democloid/picoTracker-pcb/README.md

# PCB for PicoTrackerPortable
All data in order to fabricate the PCB for the portable version of [picoTracker](https://github.com/democloid/picoTracker)

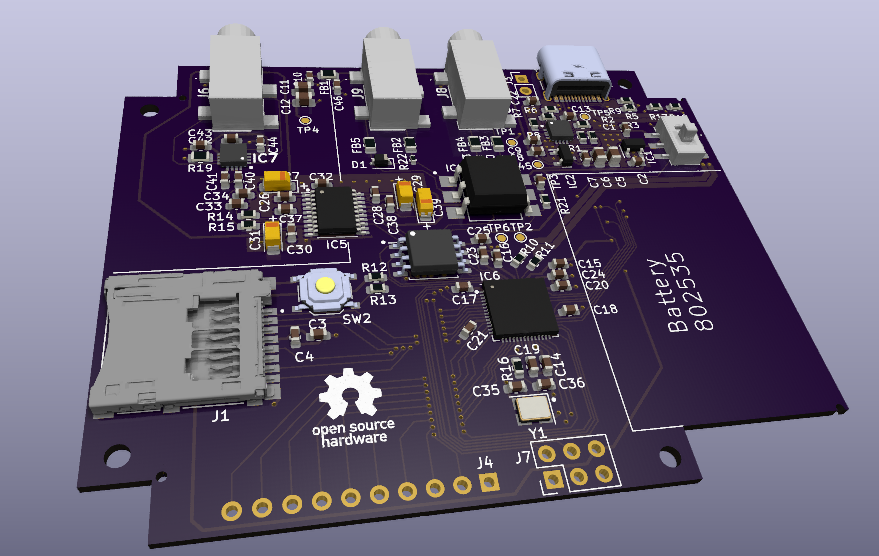
[picture p1: img/pcb.png]
picoTrakerPCB
