democloid/picoTracker-pcb/ref/2012062037_G-Switch-MS-22D28-G020_C963205.pdf

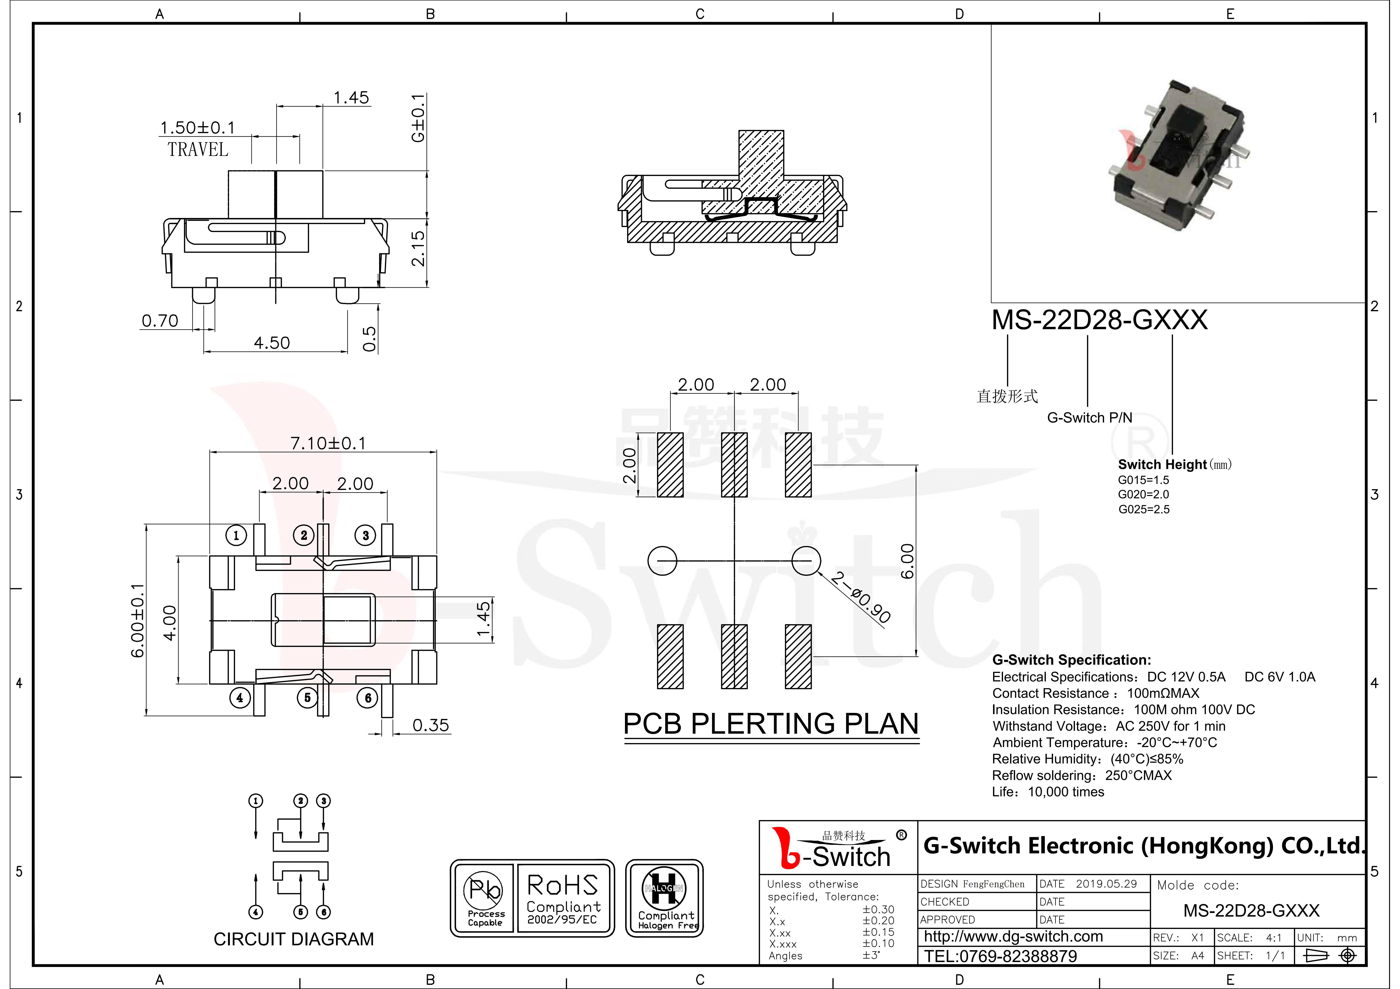
[picture p2: page 1]
