democloid/picoTracker-pcb/ref/2303271630_G-Switch-GT-USB-7010ASV_C2988369.pdf

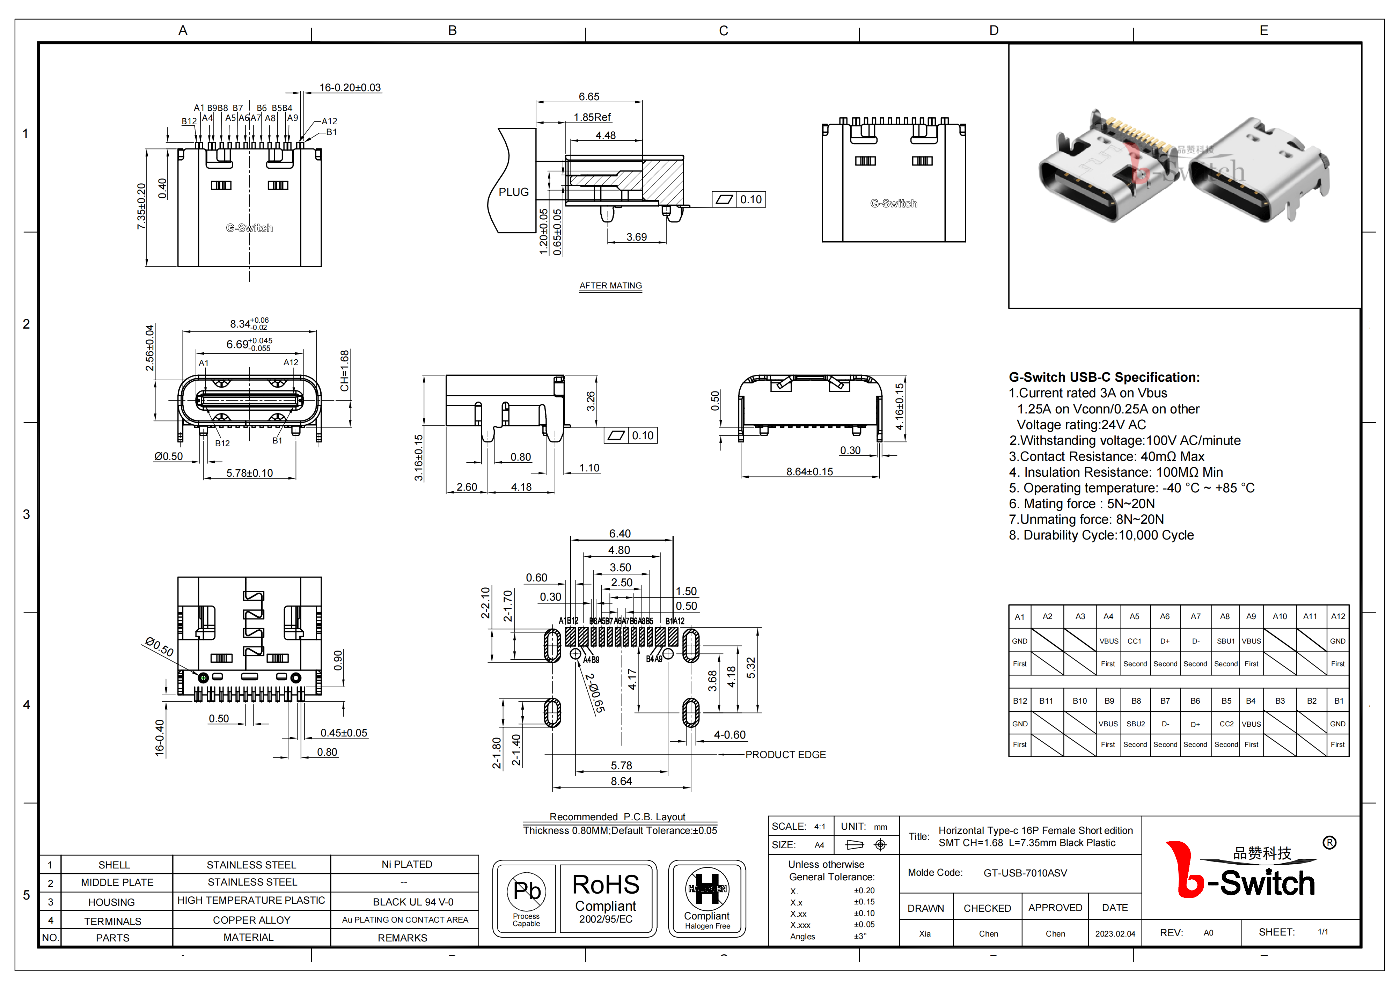
[picture p3: page 1]
