democloid/picoTracker-pcb/ref/2.8-display/H6192d027e66647838c1804a724006072S.webp

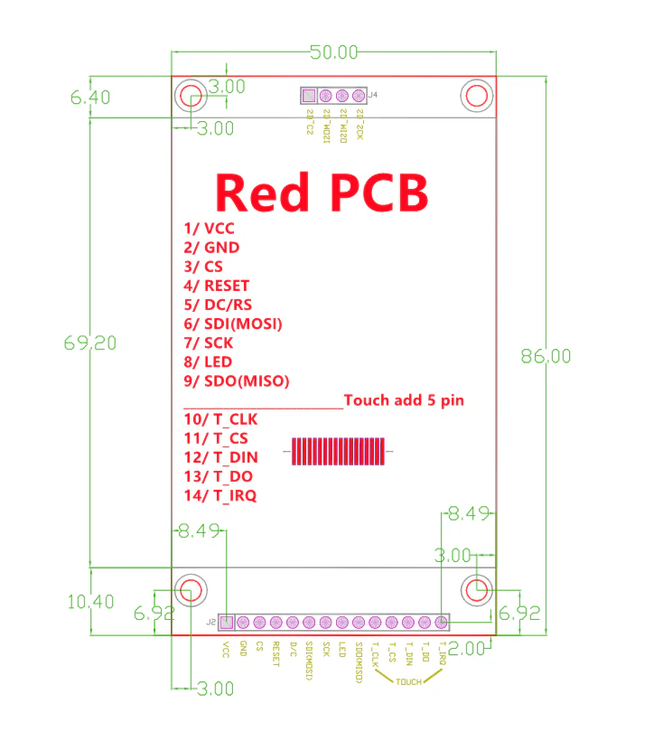
ref/2.8-display/H6192d027e66647838c1804a724006072S.webp
