democloid/picoTracker-pcb/ref/2.8-display/Hd9df9ed48139469ca7c890e34af72170M.webp

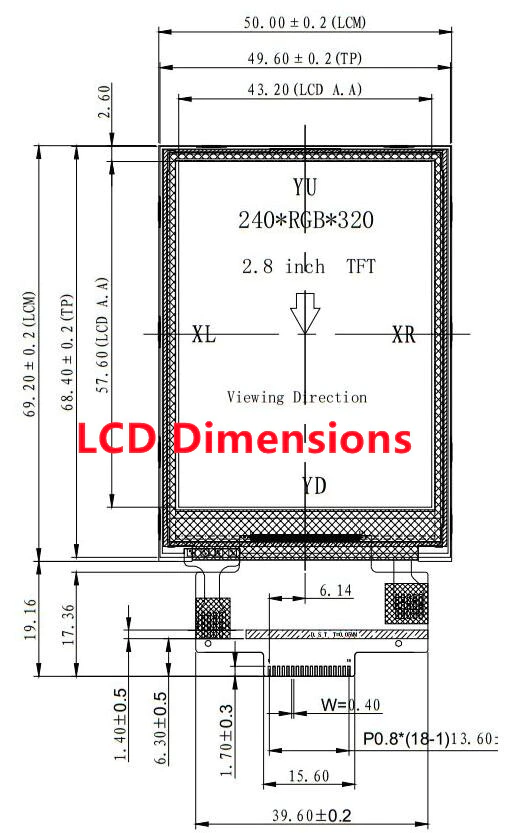
ref/2.8-display/Hd9df9ed48139469ca7c890e34af72170M.webp
