democloid/picoTracker-pcb/ref/2.8-display/He4b2adbe0c284c2fb6346b52f02b134el.webp

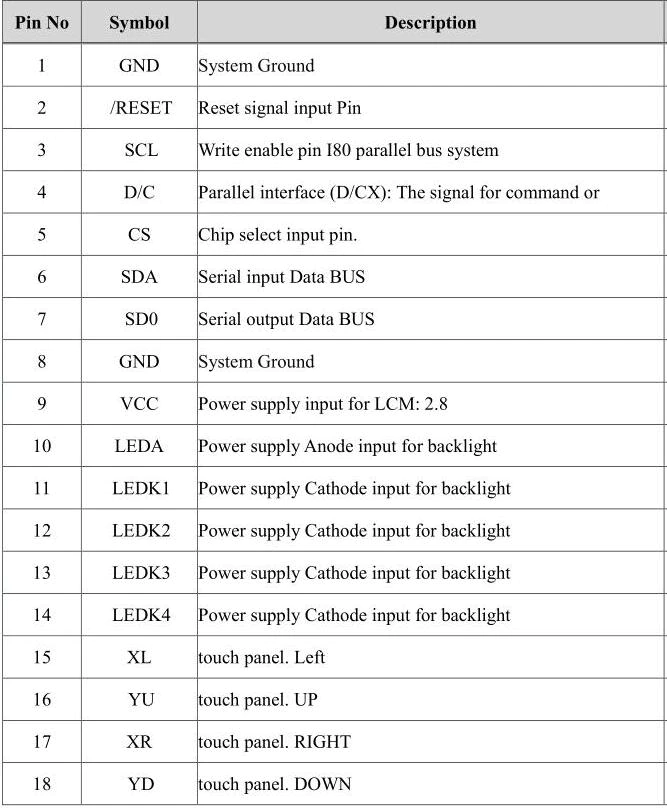
ref/2.8-display/He4b2adbe0c284c2fb6346b52f02b134el.webp
