democloid/picoTracker-pcb/ref/2.8-display/S9d542727d983450b87a73b10d5537359R.webp

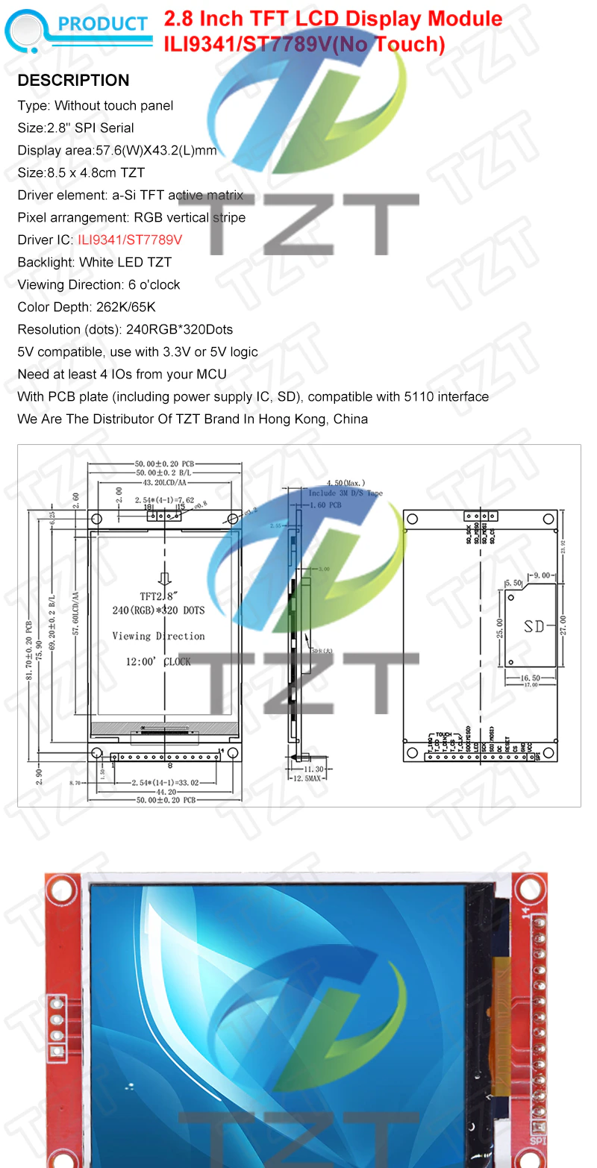
ref/2.8-display/S9d542727d983450b87a73b10d5537359R.webp
