democloid/picoTracker-pcb/ref/2.8-display/S6626c89bae8d4c0187cf21cafde3b4b0q.webp

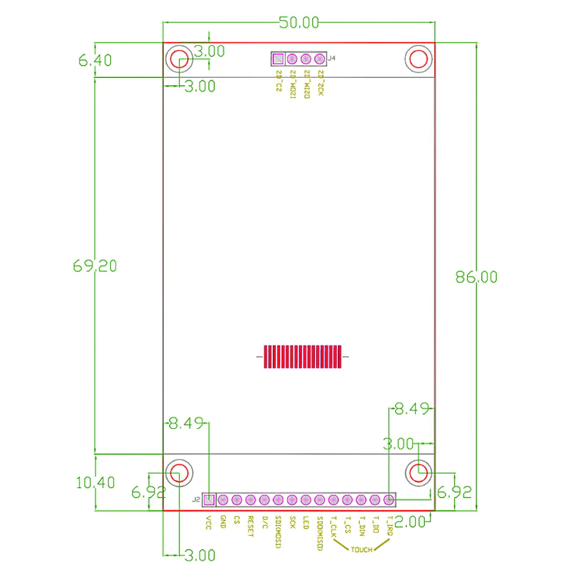
ref/2.8-display/S6626c89bae8d4c0187cf21cafde3b4b0q.webp
