democloid/picoTracker-pcb/ref/2.8-display/S024816b3a2554a78b2b5b220d4f1daffU.webp

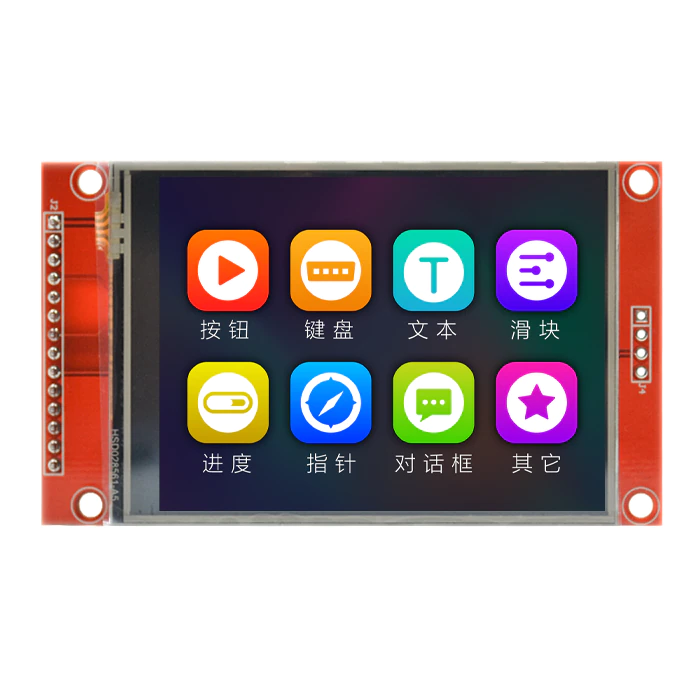
ref/2.8-display/S024816b3a2554a78b2b5b220d4f1daffU.webp
