democloid/picoTracker-pcb/ref/2.8-display/S857096e1b7784f3091919ac16b6c53cbk.webp

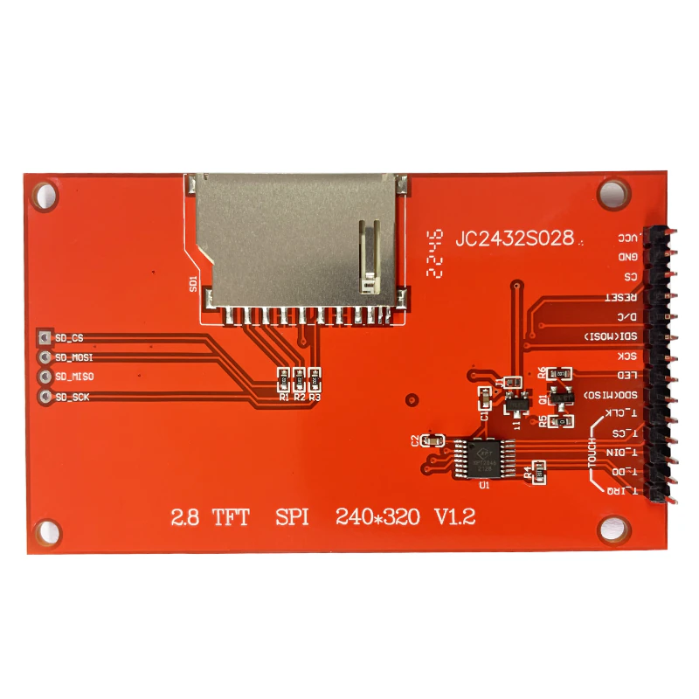
ref/2.8-display/S857096e1b7784f3091919ac16b6c53cbk.webp
