democloid/picoTracker-pcb/ref/2.8-display/Sc483274bce764f2aa723527542338a0eR.webp

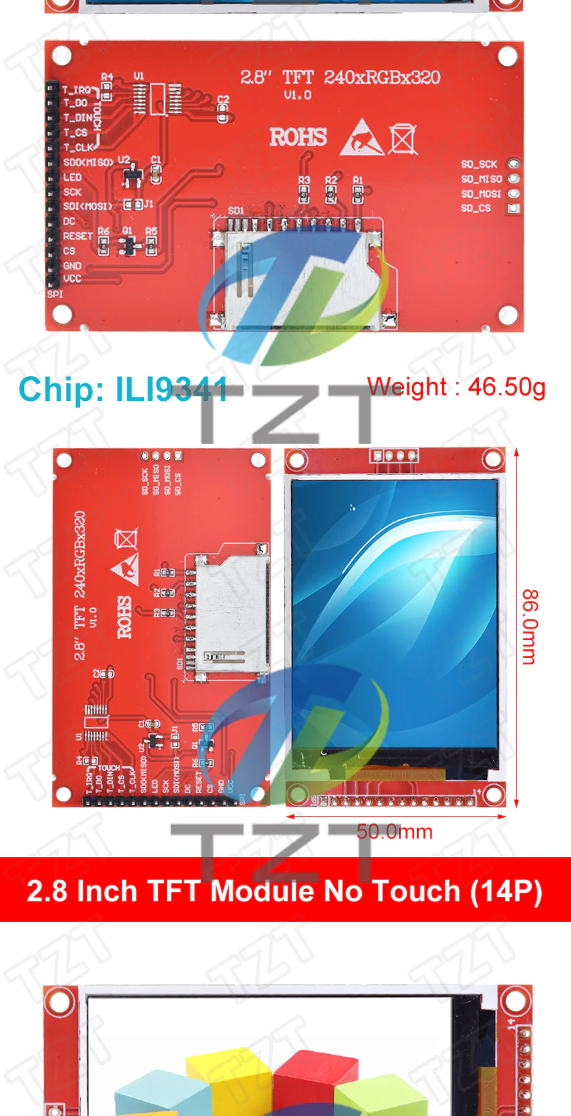
ref/2.8-display/Sc483274bce764f2aa723527542338a0eR.webp
