democloid/picoTracker-pcb/ref/71qR8LfjoXL._AC_SL1500_.jpg

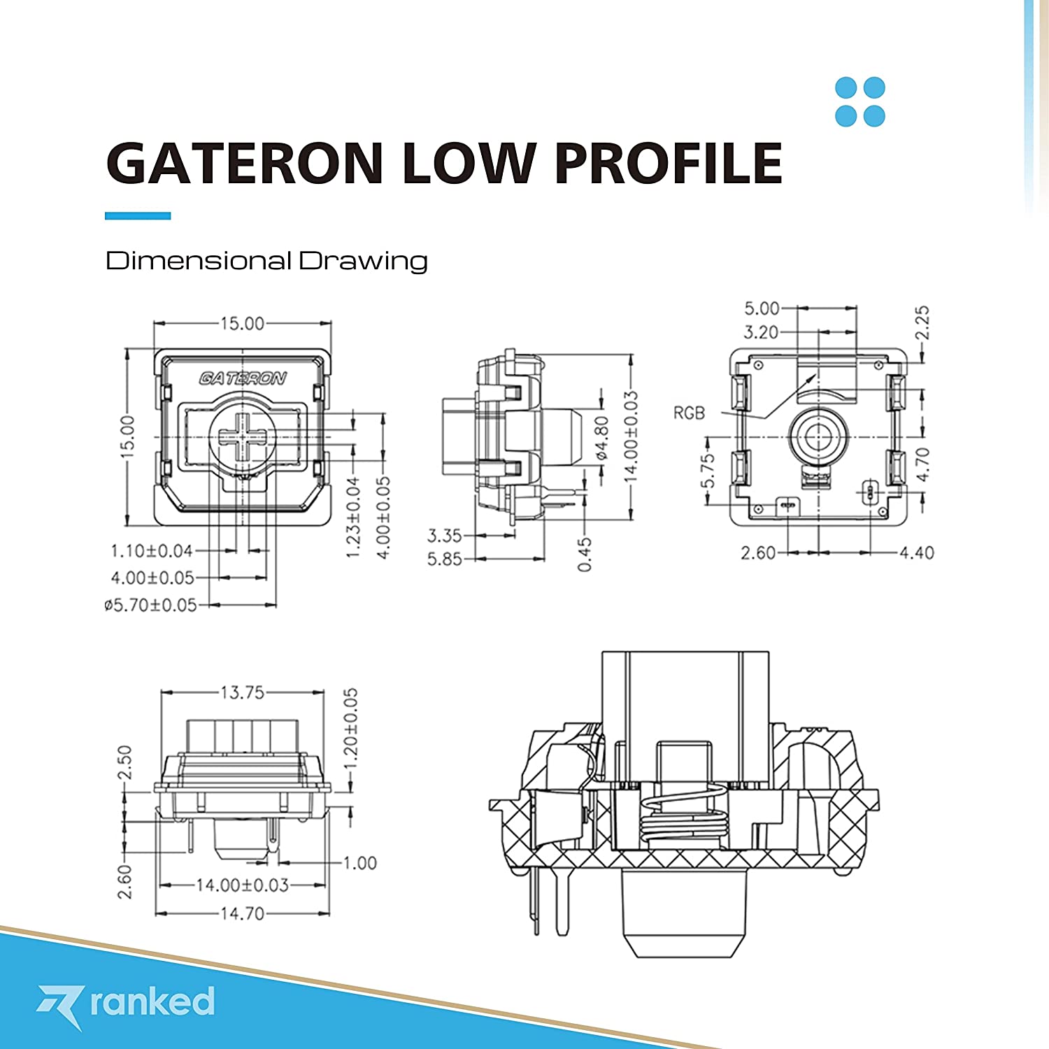
ref/71qR8LfjoXL._AC_SL1500_.jpg
