democloid/picoTracker-pcb/ref/1810121720_Korean-Hroparts-Elec-PJ-327C-4A_C145813.pdf

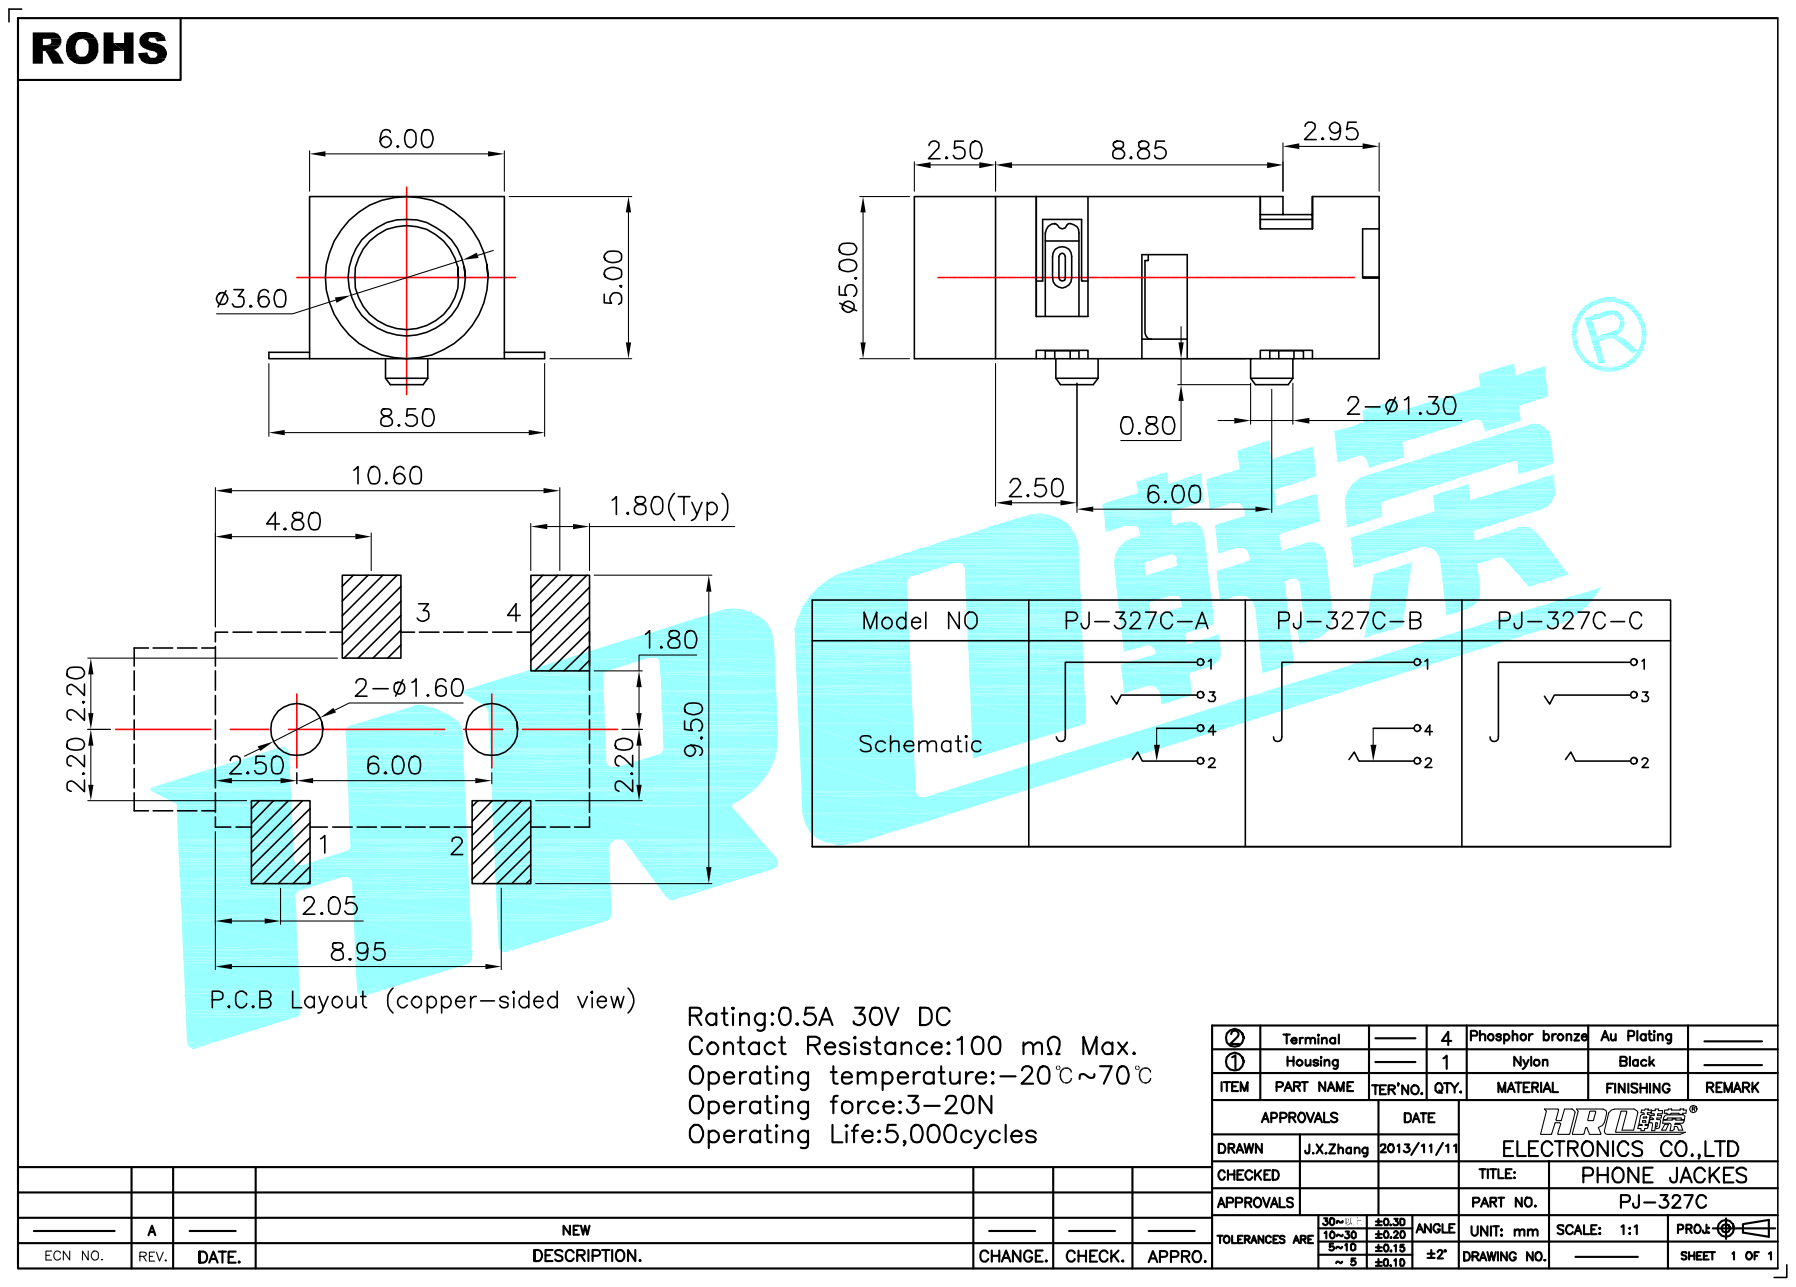
[picture p13: page 1]
