democloid/picoTracker-pcb/keys/picoTracker.kicad_pcb

## KiCad design keys/picoTracker.kicad_pcb (2023-06-05)

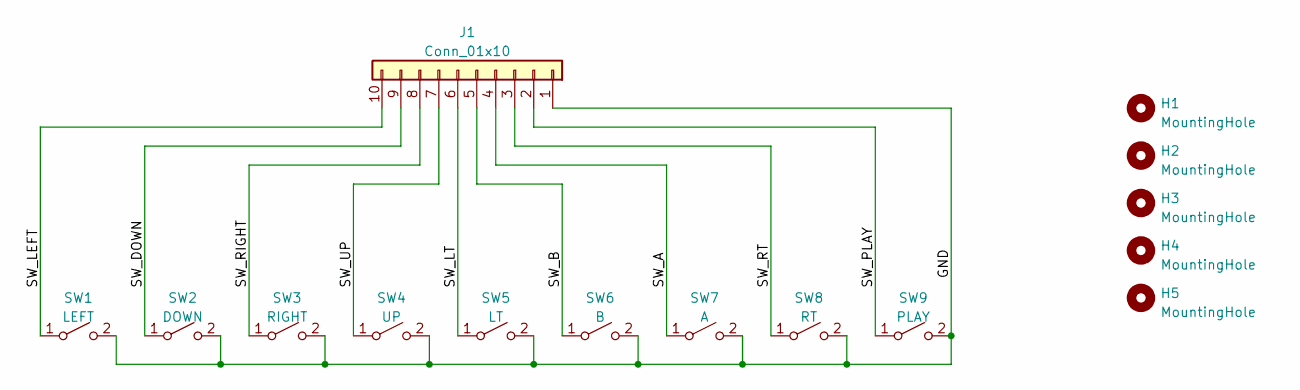
[picture p18: schematic picoTracker.kicad_sch, picoTrackerPortable keys]

Parts:
H1, H2, H3, H4, H5: MountingHole; MountingHole_2.2mm_M2
J1: Conn_01x10; PinHeader_1x10_P2.54mm_Vertical
SW1: LEFT; Cherry-MX-Low-Profile
SW2: DOWN; Cherry-MX-Low-Profile
SW3: RIGHT; Cherry-MX-Low-Profile
SW4: UP; Cherry-MX-Low-Profile
SW5: LT; Cherry-MX-Low-Profile
SW6: B; Cherry-MX-Low-Profile
SW7: A; Cherry-MX-Low-Profile
SW8: RT; Cherry-MX-Low-Profile
SW9: PLAY; Cherry-MX-Low-Profile

Connections:
/GND: J1.1, SW1.2 (B), SW2.2 (B), SW3.2 (B), SW4.2 (B), SW5.2 (B), SW6.2 (B), SW7.2 (B), SW8.2 (B), SW9.2 (B)
/SW_A: J1.4, SW7.1 (A)
/SW_B: J1.5, SW6.1 (A)
/SW_DOWN: J1.9, SW2.1 (A)
/SW_LEFT: J1.10, SW1.1 (A)
/SW_LT: J1.6, SW5.1 (A)
/SW_PLAY: J1.2, SW9.1 (A)
/SW_RIGHT: J1.8, SW3.1 (A)
/SW_RT: J1.3, SW8.1 (A)
/SW_UP: J1.7, SW4.1 (A)

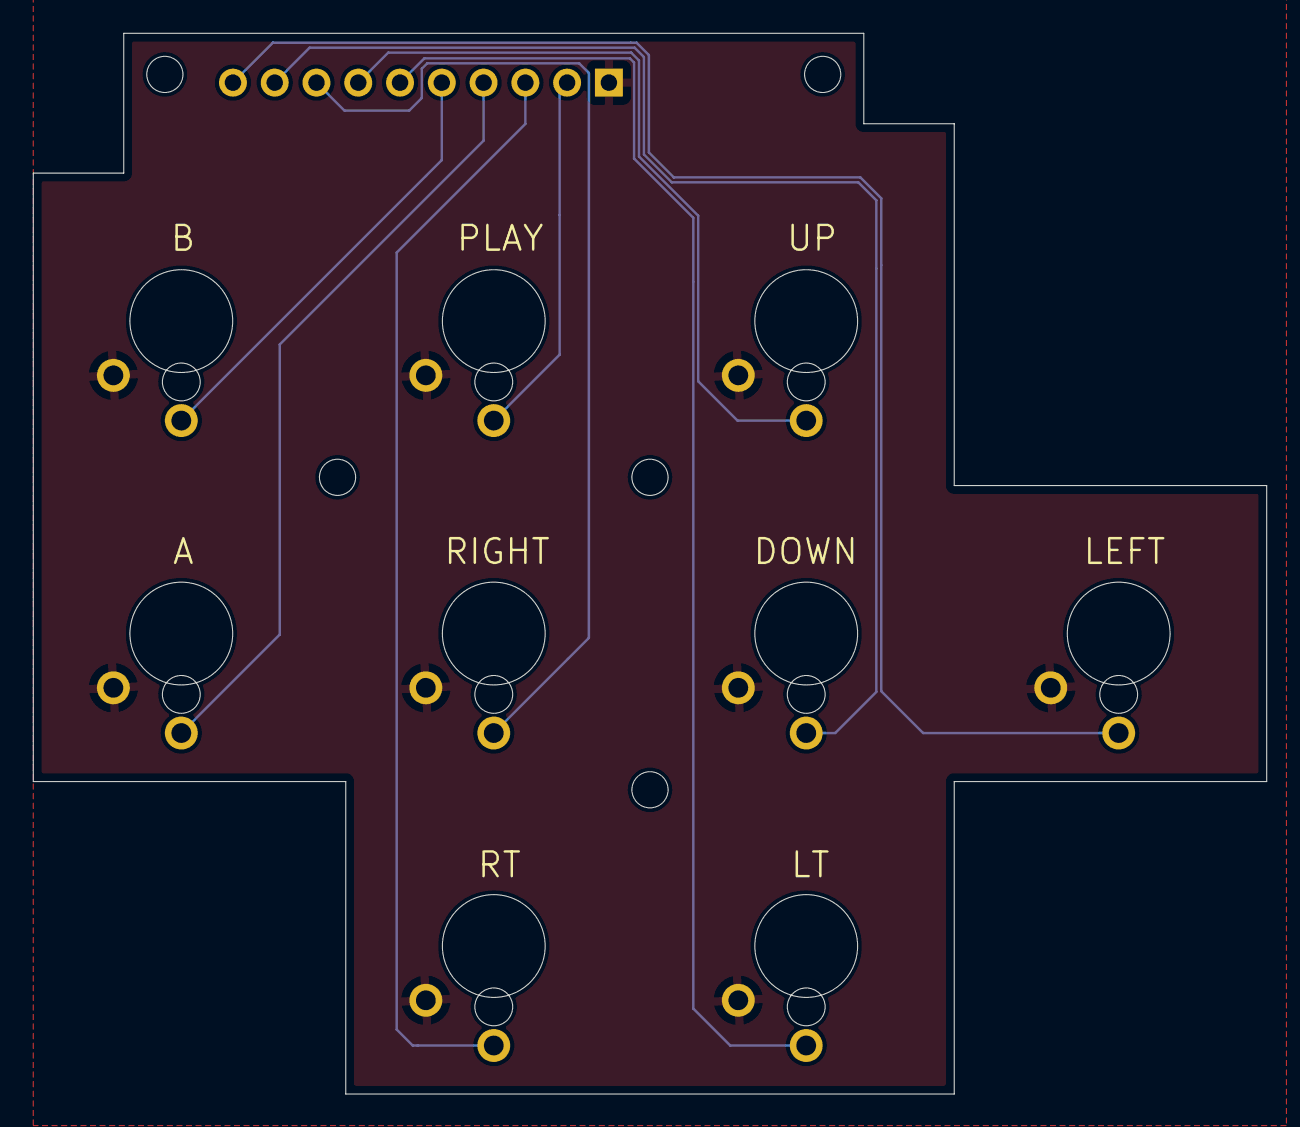
[picture p19: board keys/picoTracker.kicad_pcb from above]

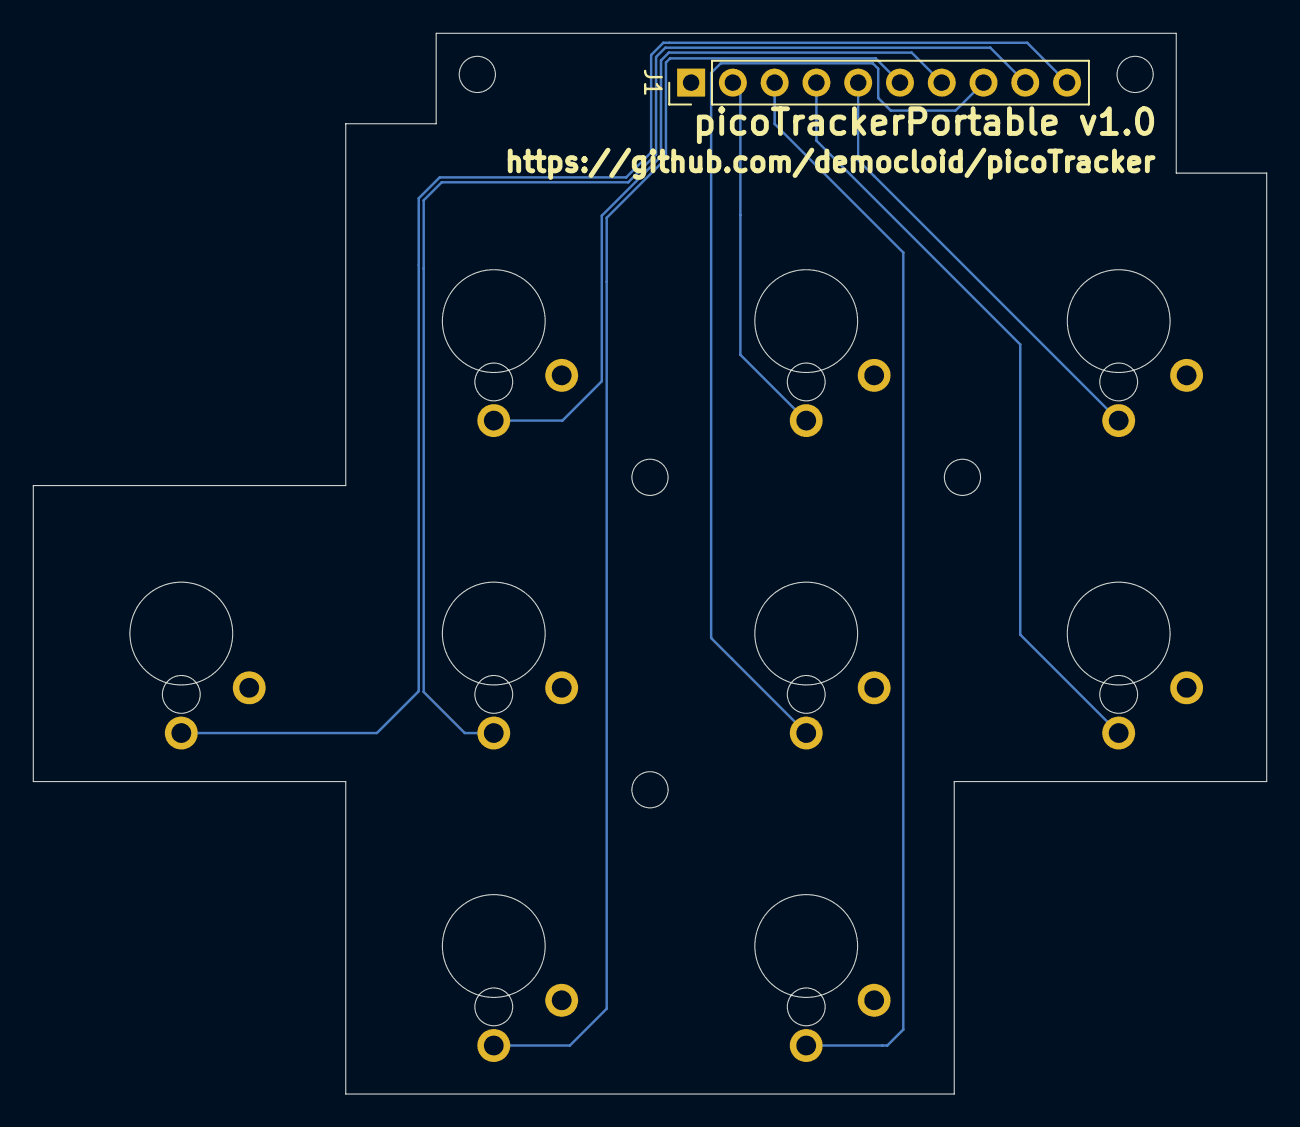
[picture p20: board keys/picoTracker.kicad_pcb from below]

Board: 2 copper layers, 75.0 x 64.5 mm, 15 parts (10 on the bottom side), 10 nets.
