democloid/picoTracker-pcb/main/picoTracker.kicad_pcb

## KiCad design main/picoTracker.kicad_pcb (2023-06-05)

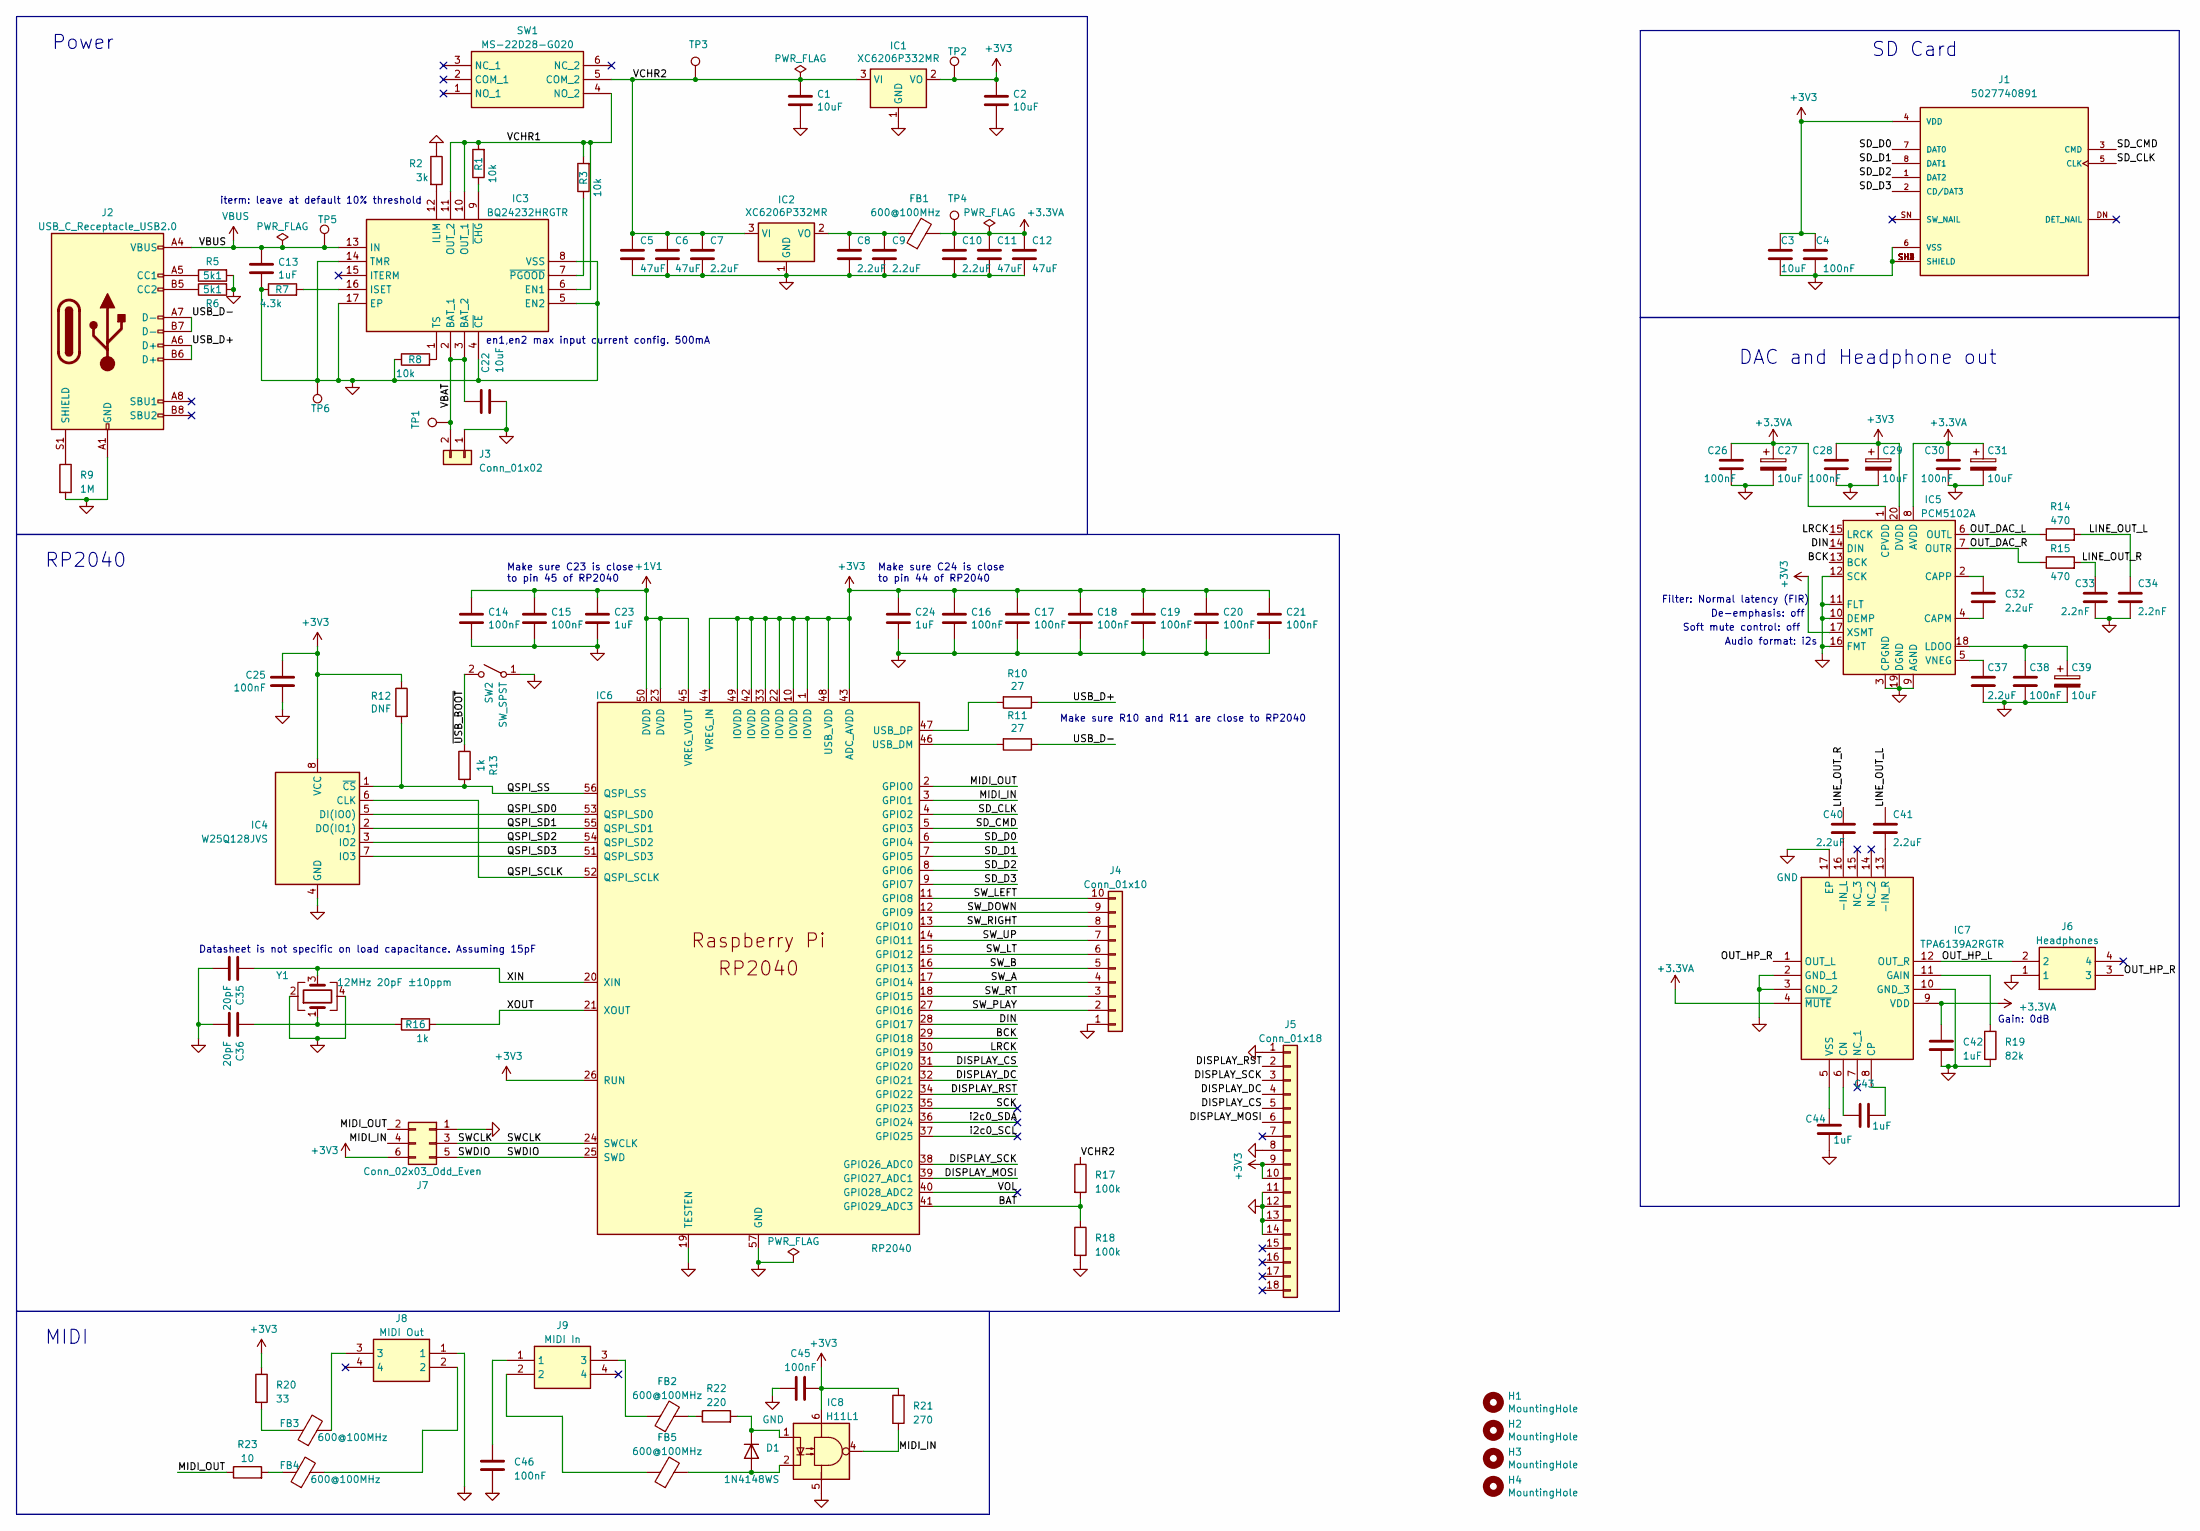
[picture p21: schematic picoTracker.kicad_sch]

Parts:
C1, C2, C3, C22: 10uF; C_0603_1608Metric; LCSC C19702
C4, C14, C15, C16, C17, C18, C19, C20, C21, C25, C26, C28, C30, C38, C45, C46: 100nF; C_0603_1608Metric; LCSC C14663
C5, C6, C11, C12: 47uF; C_0805_2012Metric; LCSC C16780
C7, C8, C9, C10, C32, C37, C40, C41: 2.2uF; C_0603_1608Metric; LCSC C23630
C13, C23, C24, C42, C43, C44: 1uF; C_0603_1608Metric; LCSC C15849
C27, C29, C31, C39: 10uF; CP_EIA-3216-18_Kemet-A; LCSC C7171
C33, C34: 2.2nF; C_0603_1608Metric; LCSC C1604
C35, C36: 20pF; C_0603_1608Metric; LCSC C1648
D1: 1N4148WS; D_SOD-323; LCSC C2128
FB1, FB2, FB3, FB4, FB5: 600@100MHz; R_0805_2012Metric; LCSC C1017
H1, H2, H3, H4: MountingHole; MountingHole_2.2mm_M2
IC1, IC2: XC6206P332MR; SOT-23; LCSC C5446
IC3: BQ24232HRGTR; QFN50P300X300X100-17N-D; Mouser Part Number 595-BQ24232HRGTR
IC4: W25Q128JVS; SOIC-8_5.23x5.23mm_P1.27mm; LCSC C97521
IC5: PCM5102A; TSSOP-20_4.4x6.5mm_P0.65mm; LCSC C107671
IC6: RP2040; QFN-56-1EP_7x7mm_P0.4mm_EP3.2x3.2mm; LCSC C2040
IC7: TPA6139A2RGTR; QFN50P300X300X100-17N-D; Mouser Part Number 595-TPA6139A2RGTR
IC8: H11L1; SMDIP-6_W9.53mm; LCSC C78589
J1: 5027740891; MOLEX_5027740891; PARTREV D; LCSC C330255
J2: USB_C_Receptacle_USB2.0; USB_C_Receptacle_G-Switch_GT-USB-7010ASV; LCSC C2988369
J3: Conn_01x02; PinHeader_1x02_P2.54mm_Vertical
J4: Conn_01x10; PinHeader_1x10_P2.54mm_Vertical
J5: Conn_01x18; QD-TFT2803
J6: Headphones; PJ327C4A; Manufacturer_Part_Number PJ-327C-4A; LCSC C145813
J7: Conn_02x03_Odd_Even; PinHeader_2x03_P2.54mm_Vertical
J8: MIDI Out; PJ327C4A; Manufacturer_Part_Number PJ-327C-4A; LCSC C145813
J9: MIDI In; PJ327C4A; Manufacturer_Part_Number PJ-327C-4A; LCSC C145813
R1, R3, R8: 10k; R_0603_1608Metric; LCSC C25804
R2: 3k; R_0603_1608Metric; LCSC C4211
R5, R6: 5k1; R_0603_1608Metric; LCSC C23186
R7: 4.3k; R_0603_1608Metric; LCSC C23159
R9: 1M; R_0603_1608Metric; LCSC C22935
R10, R11: 27; R_0603_1608Metric; LCSC C25190
R12: DNF; R_0603_1608Metric
R13, R16: 1k; R_0603_1608Metric; LCSC C21190
R14, R15: 470; R_0603_1608Metric; LCSC C23179
R17, R18: 100k; R_0603_1608Metric; LCSC C25803
R19: 82k; R_0805_2012Metric; LCSC C17840
R20: 33; R_0603_1608Metric; LCSC C23140
R21: 270; R_0603_1608Metric; LCSC C22966
R22: 220; R_0402_1005Metric; LCSC C25905
R23: 10; R_0603_1608Metric; LCSC C22859
SW1: MS-22D28-G020; MS22D28G020; Manufacturer_Part_Number MS-22D28-G020; LCSC C963205
SW2: SW_SPST; SW_Push_1P1T_XKB_TS-1187A; LCSC C318884
TP1: VBAT; TestPoint_Pad_D1.0mm
TP2: TestPoint; TestPoint_Pad_D1.0mm
TP3: VCHR; TestPoint_Pad_D1.0mm
TP4: 3.3VA; TestPoint_Pad_D1.0mm
TP5: VBUS; TestPoint_Pad_D1.0mm
TP6: GND; TestPoint_Pad_D1.0mm
Y1: 12MHz 20pF ±10ppm; Crystal_SMD_3225-4Pin_3.2x2.5mm; LCSC C9002

Connections:
+1V1: C14.1, C15.1, C23.1, IC6.23 (DVDD), IC6.45 (VREG_VOUT), IC6.50 (DVDD)
+3.3VA: C10.1, C11.1, C12.1, C26.1, C27.1, C30.1, C31.1, C42.1, FB1.2, IC5.1 (CPVDD), IC5.8 (AVDD), IC7.4 (~MUTE), IC7.9 (VDD), TP4.1
+3V3: C2.1, C3.1, C4.1, C16.1, C17.1, C18.1, C19.1, C20.1, C21.1, C24.1, C25.1, C28.1, C29.1, C45.2, IC1.2 (VO), IC4.8 (VCC), IC5.17 (XSMT), IC5.20 (DVDD), IC6.1 (IOVDD), IC6.10 (IOVDD), IC6.22 (IOVDD), IC6.26 (RUN), IC6.33 (IOVDD), IC6.42 (IOVDD), IC6.43 (ADC_AVDD), IC6.44 (VREG_IN), IC6.48 (USB_VDD), IC6.49 (IOVDD), IC8.6, J1.4 (VDD), J5.9, J5.10, J7.6, R12.1, R20.1, R21.2, TP2.1
/BAT: IC6.41 (GPIO29_ADC3), R17.2, R18.1
/BCK: IC5.13 (BCK), IC6.29 (GPIO18)
/DIN: IC5.14 (DIN), IC6.28 (GPIO17)
/DISPLAY_CS: IC6.31 (GPIO20), J5.5
/DISPLAY_DC: IC6.32 (GPIO21), J5.4
/DISPLAY_MOSI: IC6.39 (GPIO27_ADC1), J5.6
/DISPLAY_RST: IC6.34 (GPIO22), J5.2
/DISPLAY_SCK: IC6.38 (GPIO26_ADC0), J5.3
/LINE_OUT_L: C34.1, C41.1, R14.2
/LINE_OUT_R: C33.1, C40.1, R15.2
/LRCK: IC5.15 (LRCK), IC6.30 (GPIO19)
/MIDI_IN: IC6.3 (GPIO1), IC8.4, J7.4, R21.1
/MIDI_OUT: IC6.2 (GPIO0), J7.2, R23.1
/OUT_DAC_L: IC5.6 (OUTL), R14.1
/OUT_DAC_R: IC5.7 (OUTR), R15.1
/OUT_HP_L: IC7.12 (OUT_R), J6.2
/OUT_HP_R: IC7.1 (OUT_L), J6.3
/QSPI_SCLK: IC4.6 (CLK), IC6.52 (QSPI_SCLK)
/QSPI_SD0: IC4.5 (DI(IO0)), IC6.53 (QSPI_SD0)
/QSPI_SD1: IC4.2 (DO(IO1)), IC6.55 (QSPI_SD1)
/QSPI_SD2: IC4.3 (IO2), IC6.54 (QSPI_SD2)
/QSPI_SD3: IC4.7 (IO3), IC6.51 (QSPI_SD3)
/QSPI_SS: IC4.1 (~CS), IC6.56 (QSPI_SS), R12.2, R13.2
/SCK: IC6.35 (GPIO23)
/SD_CLK: IC6.4 (GPIO2), J1.5 (CLK)
/SD_CMD: IC6.5 (GPIO3), J1.3 (CMD)
/SD_D0: IC6.6 (GPIO4), J1.7 (DAT0)
/SD_D1: IC6.7 (GPIO5), J1.8 (DAT1)
/SD_D2: IC6.8 (GPIO6), J1.1 (DAT2)
/SD_D3: IC6.9 (GPIO7), J1.2 (CD/DAT3)
/SWCLK: IC6.24 (SWCLK), J7.3
/SWDIO: IC6.25 (SWD), J7.5
/SW_A: IC6.17 (GPIO14), J4.4
/SW_B: IC6.16 (GPIO13), J4.5
/SW_DOWN: IC6.12 (GPIO9), J4.9
/SW_LEFT: IC6.11 (GPIO8), J4.10
/SW_LT: IC6.15 (GPIO12), J4.6
/SW_PLAY: IC6.27 (GPIO16), J4.2
/SW_RIGHT: IC6.13 (GPIO10), J4.8
/SW_RT: IC6.18 (GPIO15), J4.3
/SW_UP: IC6.14 (GPIO11), J4.7
/USB_D+: J2.A6 (D+), J2.B6 (D+), R10.1
/USB_D-: J2.A7 (D-), J2.B7 (D-), R11.1
/VBAT: C22.1, IC3.2 (BAT_1), IC3.3 (BAT_2), J3.2, TP1.1
/VCHR1: IC3.6 (EN1), IC3.10 (OUT_1), IC3.11 (OUT_2), R1.2, R3.2, SW1.4 (NO_2)
/VCHR2: C1.1, C5.1, C6.1, C7.1, IC1.3 (VI), IC2.3 (VI), R17.1, SW1.5 (COM_2), TP3.1
/VOL: IC6.40 (GPIO28_ADC2)
/XIN: C35.1, IC6.20 (XIN), Y1.3
/XOUT: IC6.21 (XOUT), R16.1
/i2c0_SCL: IC6.37 (GPIO25)
/i2c0_SDA: IC6.36 (GPIO24)
/~USB_BOOT: R13.1, SW2.2 (B)
GND: C1.2, C2.2, C3.2, C4.2, C5.2, C6.2, C7.2, C8.2, C9.2, C10.2, C11.2, C12.2, C13.2, C14.2, C15.2, C16.2, C17.2, C18.2, C19.2, C20.2, C21.2, C22.2, C23.2, C24.2, C25.2, C26.2, C27.2, C28.2, C29.2, C30.2, C31.2, C33.2, C34.2, C35.2, C36.2, C37.2, C38.2, C39.2, C42.2, C44.2, C45.1, C46.2, IC1.1 (GND), IC2.1 (GND), IC3.4 (~CE), IC3.5 (EN2), IC3.8 (VSS), IC3.14 (TMR), IC3.17 (EP), IC4.4 (GND), IC5.3 (CPGND), IC5.9 (AGND), IC5.10 (DEMP), IC5.11 (FLT), IC5.12 (SCK), IC5.16 (FMT), IC5.19 (DGND), IC6.19 (TESTEN), IC6.57 (GND), IC7.2 (GND_1), IC7.3 (GND_2), IC7.10 (GND_3), IC7.17 (EP), IC8.5, J1.6 (VSS), J1.SH1 (SHIELD), J1.SH2 (SHIELD), J1.SH3 (SHIELD), J1.SH4 (SHIELD), J2.A1 (GND), J2.A12 (GND), J2.B1 (GND), J2.B12 (GND), J3.1, J4.1, J5.1, J5.8, J5.11, J5.12, J5.13, J5.14, J6.1, J7.1, J8.1, R2.1, R5.2, R6.2, R7.1, R8.1, R9.2, R18.2, R19.2, SW2.1 (A), TP6.1, Y1.2, Y1.4
unnamed: C36.1, R16.2, Y1.1
unnamed: C46.1, J9.1
unnamed: D1.2 (A), FB5.2, IC8.2
unnamed: D1.1 (K), IC8.1, R22.2
unnamed: FB2.1, J9.3
unnamed: FB2.2, R22.1
unnamed: FB3.1, R20.2
unnamed: FB3.2, J8.3
unnamed: FB4.1, R23.2
unnamed: FB4.2, J8.2
unnamed: FB5.1, J9.2
unnamed: C8.1, C9.1, FB1.1, IC2.2 (VO)
unnamed: IC3.12 (ILIM), R2.2
unnamed: IC3.16 (ISET), R7.2
unnamed: IC3.1 (TS), R8.2
unnamed: IC3.9 (~CHG), R1.1
unnamed: IC3.7 (~PGOOD), R3.1
unnamed: C32.2, IC5.4 (CAPM)
unnamed: C32.1, IC5.2 (CAPP)
unnamed: C38.1, C39.1, IC5.18 (LDOO)
unnamed: C37.1, IC5.5 (VNEG)
unnamed: IC6.46 (USB_DM), R11.2
unnamed: IC6.47 (USB_DP), R10.2
unnamed: C40.2, IC7.16 (-IN_L)
unnamed: C41.2, IC7.13 (-IN_R)
unnamed: C43.1, IC7.6 (CN)
unnamed: C43.2, IC7.8 (CP)
unnamed: IC7.11 (GAIN), R19.1
unnamed: C44.1, IC7.5 (VSS)
unnamed: J2.A5 (CC1), R5.1
unnamed: J2.B5 (CC2), R6.1
unnamed: J2.S1 (SHIELD), R9.1
VBUS: C13.1, IC3.13 (IN), J2.A4 (VBUS), J2.A9 (VBUS), J2.B4 (VBUS), J2.B9 (VBUS), TP5.1

Notes on the sheet:
DAC and Headphone out
iterm: leave at default 10% threshold
SD Card
en1,en2 max input current config. 500mA
Power
RP2040
Filter: Normal latency (FIR)
Datasheet is not specific on load capacitance. Assuming 15pF
Make sure C23 is close to pin 45 of RP2040
Soft mute control: off
Make sure R10 and R11 are close to RP2040
Gain: 0dB
De-emphasis: off
MIDI
Audio format: i2s
Make sure C24 is close to pin 44 of RP2040

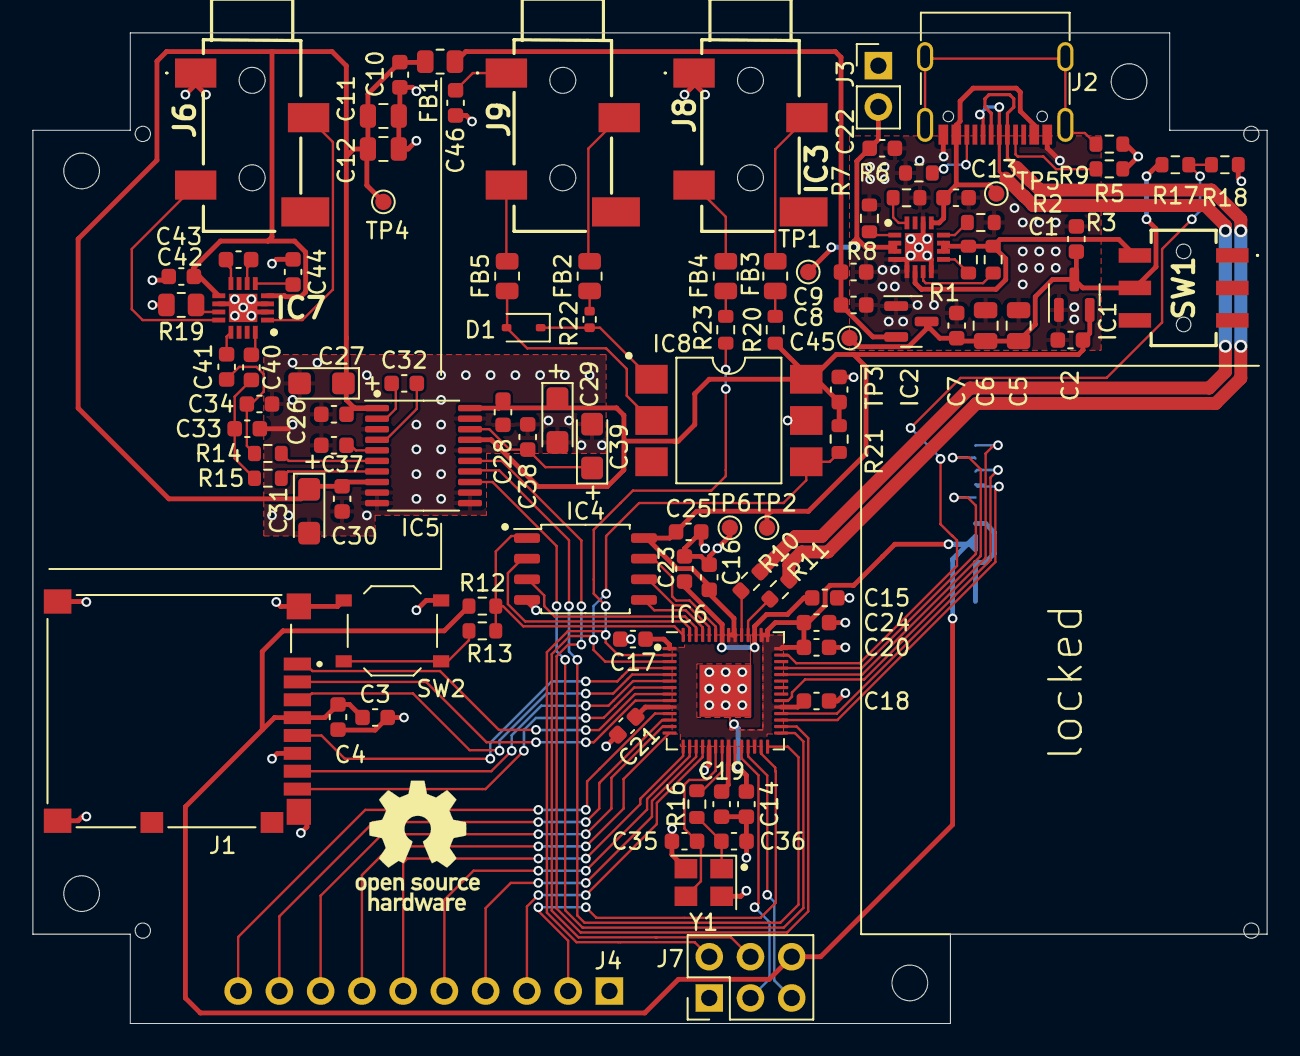
[picture p22: board main/picoTracker.kicad_pcb from above]

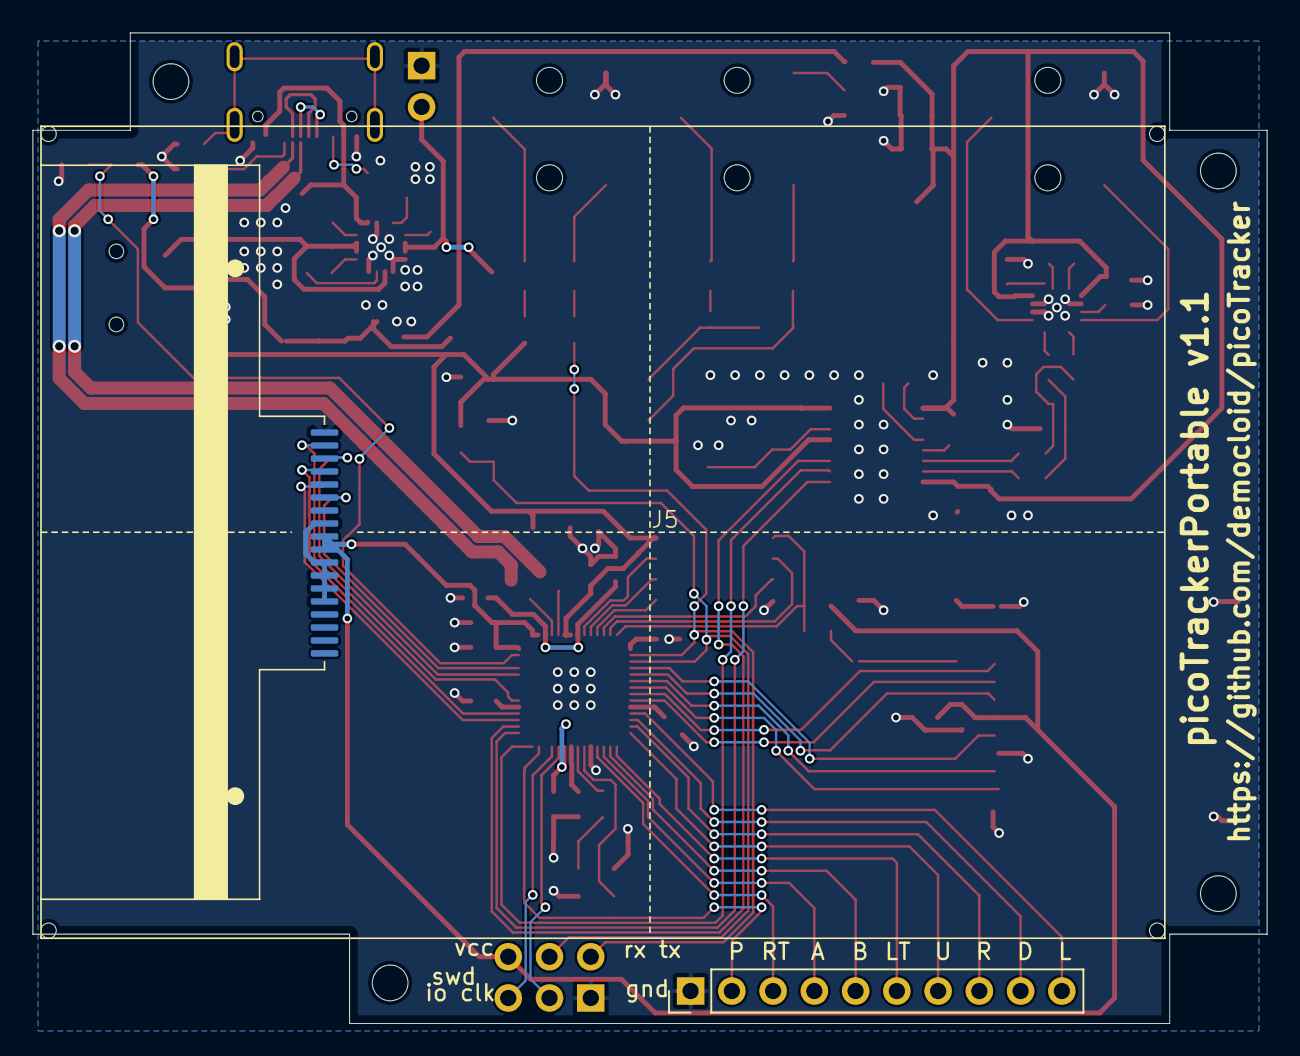
[picture p23: board main/picoTracker.kicad_pcb from below]

Board: 2 copper layers, 76.0 x 61.0 mm, 104 parts (6 on the bottom side), 85 nets.
